cowboyrushforth/graduate/PCB/rx_v2.0/tx.pdf

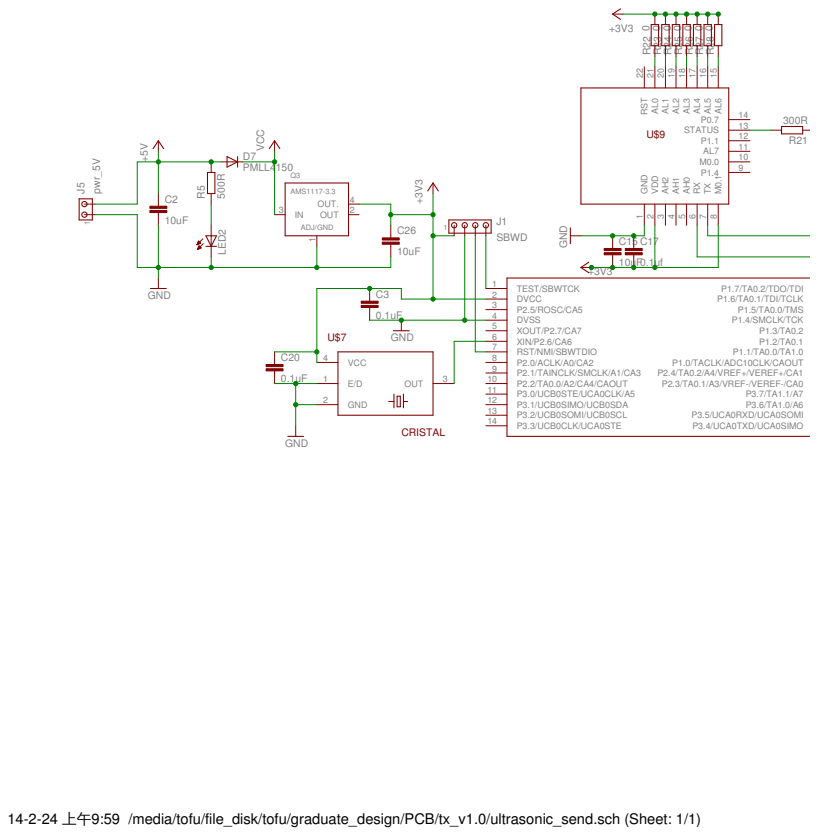
[picture p20: page 1]

P1.7/TA0.2/TDO/TDI P1.6/TA0.1/TDI/TCLK

14-2-24 上午9:59 /media/tofu/file_disk/tofu/graduate_design/PCB/tx_v1.0/ultrasonic_send.sch (Sheet: 1/1)

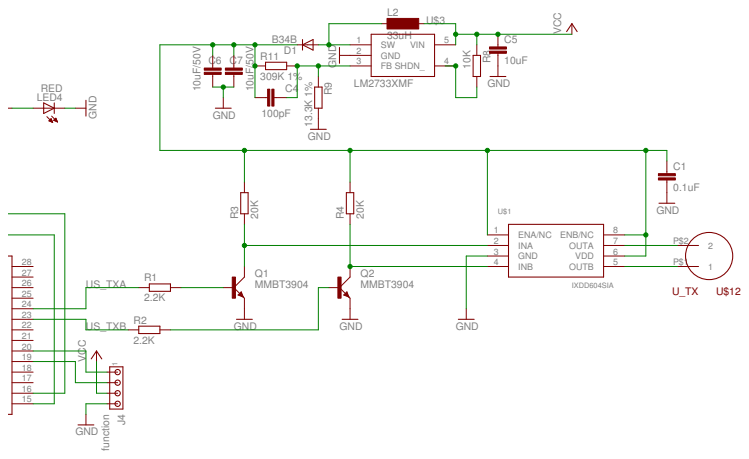
[picture p21: page 2]
