cowboyrushforth/graduate/PCB/rx_v1.0/ultrasonic_send.pdf

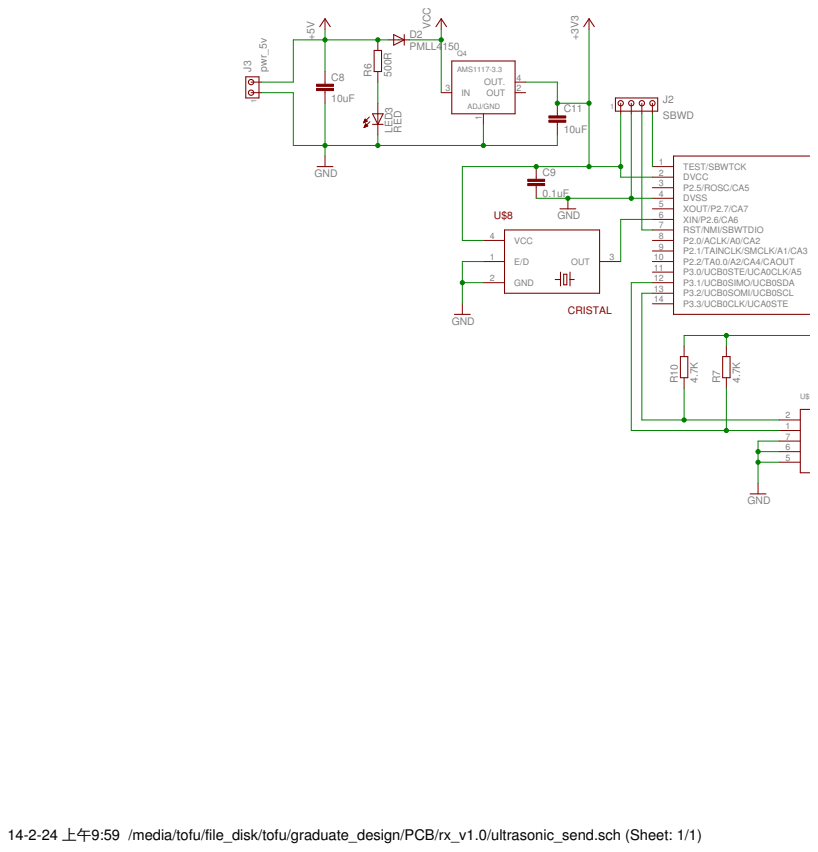
[picture p22: page 1]

14-2-24 上午9:59 /media/tofu/file_disk/tofu/graduate_design/PCB/rx_v1.0/ultrasonic_send.sch (Sheet: 1/1)

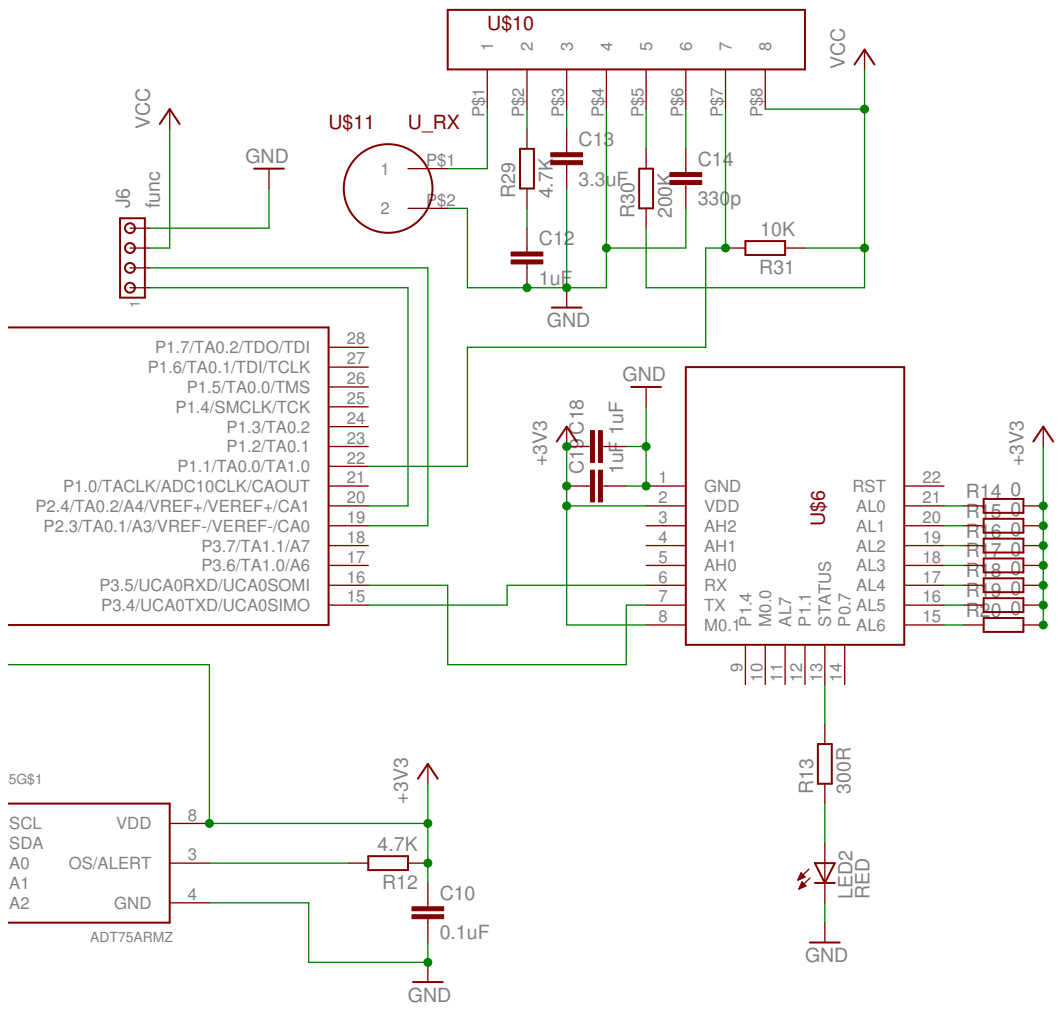
[picture p23: page 2]
