cowboyrushforth/graduate/PCB/tx_v2.0/ultrasonic_send.brd

## EAGLE design PCB/tx_v2.0/ultrasonic_send.brd (2014-04-11)

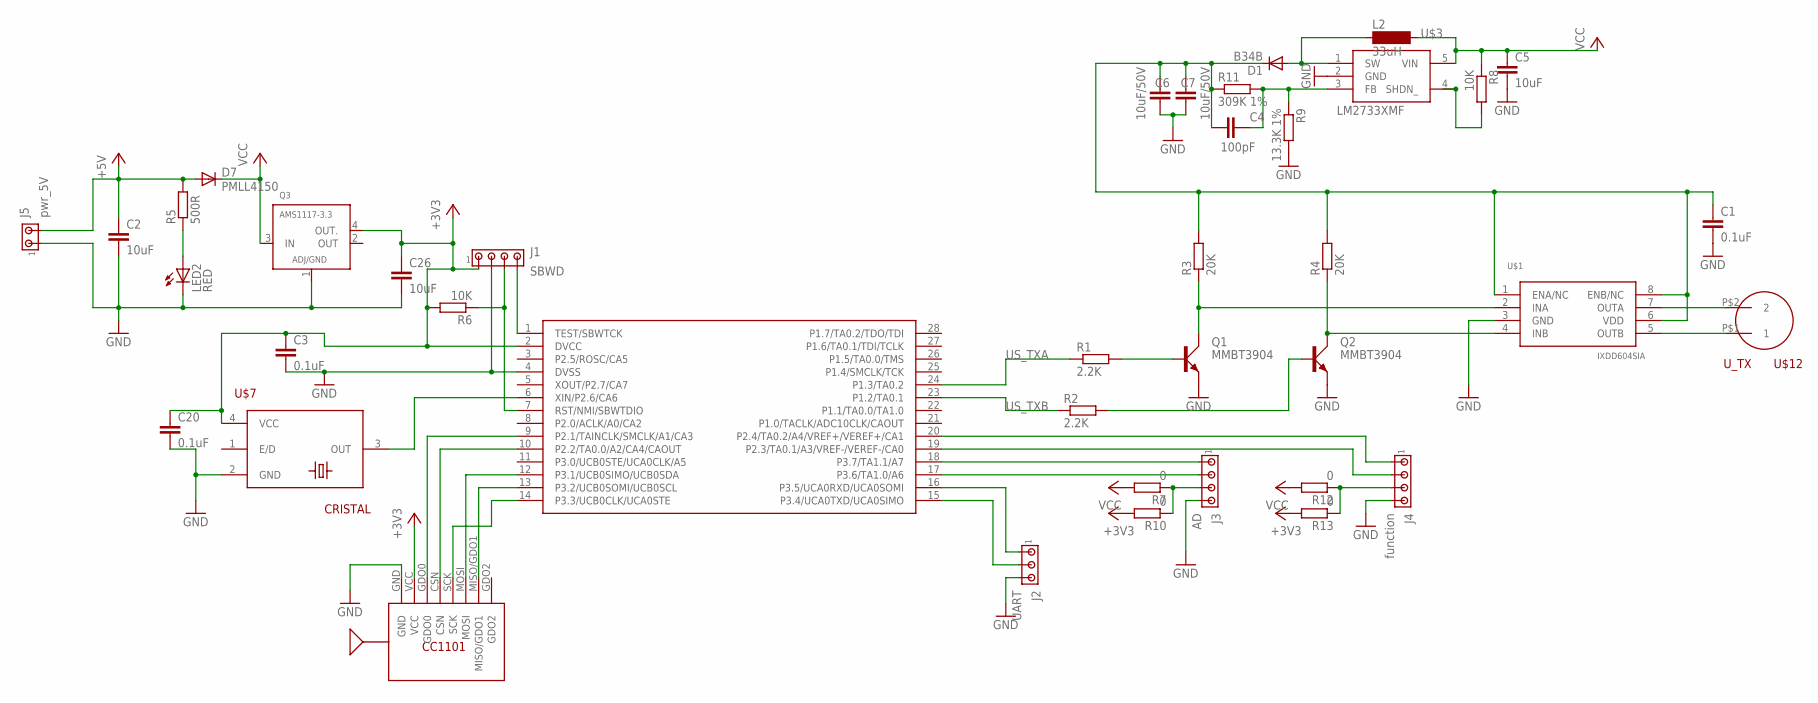
[picture p24: schematic ultrasonic_send.sch]

Parts:
C1, C3, C20: 0.1uF; C0805
C2, C5, C26: 10uF; C0805
C4: 100pF; C0805
C6, C7: 10uF/50V; C1210
D1: B34B; GF1
D7: PMLL4150; SOD80C
J1: SBWD; 10X04MTA
J2: UART; 10X03MTA
J3: AD; 10X04MTA
J4: function; 10X04MTA
J5: pwr_5V; 10X02MTA
L2: 33uH; MS85
LED2: RED; SML0805
Q1, Q2: MMBT3904; SOT23
Q3: AMS1117-3.3; SOT223-4
R1, R2: 2.2K; R0805
R3, R4: 20K; R0603
R5: 500R; R0603
R6, R8: 10K; R0603
R7, R10, R12, R13: 0; R0603
R9: 13.3K 1%; R0603
R11: 309K 1%; R0603
U$1: IXDD604SIA; SO8
U$2: MSP430F2112; PW_R-PDSO-G28
U$3: LM2733XMF; SOT23-DBV
U$4: CC1101
U$7: CRISTAL; CTS406
U$12: U_TX; ULTRASONIC

Connections:
+3V3: C3.1, C20.1, C26.1, J1.1, Q3.4 (OUT.), R6.2, R10.2, R13.2, U$2.2 (DVCC), U$4.VCC, U$7.4 (VCC)
+5V: C2.1, D7.A, J5.2, R5.2
GND: C1.2, C2.2, C3.2, C5.2, C6.2, C7.2, C20.2, C26.2, J1.2, J2.3, J3.4, J4.4, J5.1, LED2.C, Q1.2 (E), Q2.2 (E), Q3.1 (ADJ/GND), R9.2, U$1.3 (GND), U$2.4 (DVSS), U$3.2 (GND), U$4.GND, U$7.2 (GND)
unnamed: Q1.1 (B), R1.2
unnamed: Q2.1 (B), R2.2
unnamed: Q1.3 (C), R3.1, U$1.2 (INA)
unnamed: Q2.3 (C), R4.1, U$1.4 (INB)
unnamed: J1.4, U$2.1 (TEST/SBWTCK)
unnamed: LED2.A, R5.1
unnamed: U$2.6 (XIN/P2.6/CA6), U$7.3 (OUT)
unnamed: C1.1, C4.1, C6.1, C7.1, D1.C, R3.2, R4.2, R11.1, U$1.1 (ENA/NC), U$1.6 (VDD), U$1.8 (ENB/NC)
unnamed: J4.3, R12.1, R13.1
unnamed: J1.3, R6.1, U$2.7 (RST/NMI/SBWTDIO)
unnamed: U$2.9 (P2.1/TAINCLK/SMCLK/A1/CA3), U$4.GDO0
unnamed: U$2.10 (P2.2/TA0.0/A2/CA4/CAOUT), U$4.CSN
unnamed: U$2.12 (P3.1/UCB0SIMO/UCB0SDA), U$4.MOSI
unnamed: U$2.13 (P3.2/UCB0SOMI/UCB0SCL), U$4.MISO/GDO1
unnamed: U$2.14 (P3.3/UCB0CLK/UCA0STE), U$4.SCK
unnamed: J2.1, U$2.16 (P3.5/UCA0RXD/UCA0SOMI)
unnamed: J2.2, U$2.15 (P3.4/UCA0TXD/UCA0SIMO)
unnamed: J3.1, U$2.18 (P3.7/TA1.1/A7)
unnamed: J3.2, U$2.17 (P3.6/TA1.0/A6)
unnamed: J3.3, R7.1, R10.1
unnamed: R8.2, U$3.4 (SHDN_)
unnamed: D1.A, L2.1, U$3.1 (SW)
unnamed: C4.2, R9.1, R11.2, U$3.3 (FB)
unnamed: J4.1, U$2.20 (P2.4/TA0.2/A4/VREF+/VEREF+/CA1)
unnamed: U$1.7 (OUTA), U$12.P$2 (2)
unnamed: U$1.5 (OUTB), U$12.P$1 (1)
unnamed: J4.2, U$2.19 (P2.3/TA0.1/A3/VREF-/VEREF-/CA0)
OUT: Q3.2 (OUT)
US_TXA: R1.1, U$2.24 (P1.3/TA0.2)
US_TXB: R2.1, U$2.23 (P1.2/TA0.1)
VCC: C5.1, D7.C, L2.2, Q3.3 (IN), R7.2, R8.1, R12.2, U$3.5 (VIN)

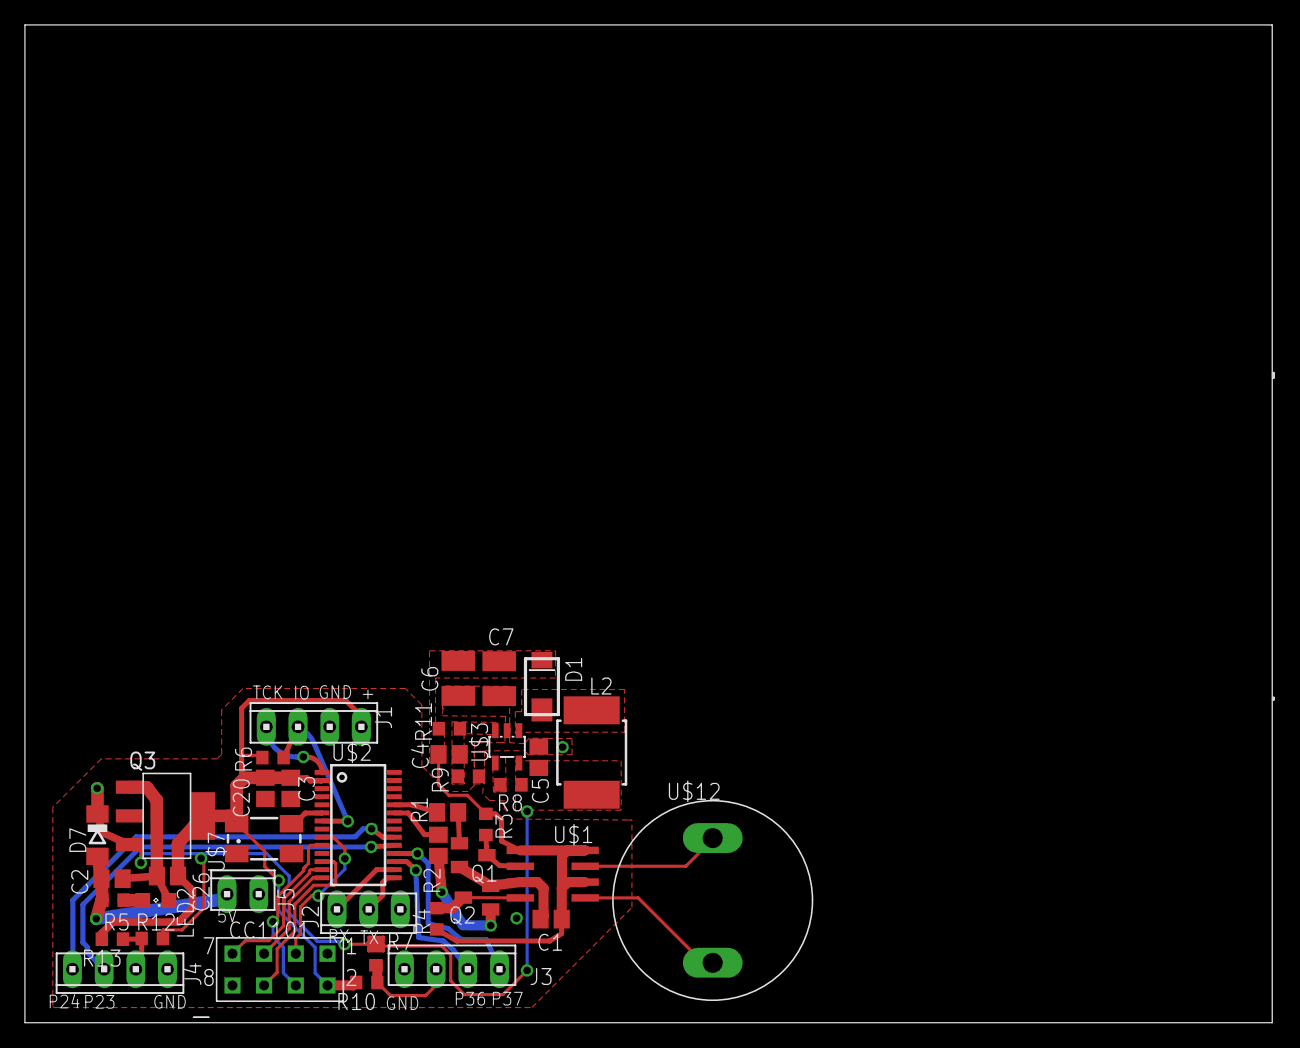
[picture p25: board PCB/tx_v2.0/ultrasonic_send.brd from above]

Board: 2 copper layers, 100.0 x 80.0 mm, 40 parts (0 on the bottom side), 33 nets.
