cowboyrushforth/graduate/PCB/rx_v1.0/ultrasonic_send.brd

## EAGLE design PCB/rx_v1.0/ultrasonic_send.brd (2014-03-02, an earlier design)

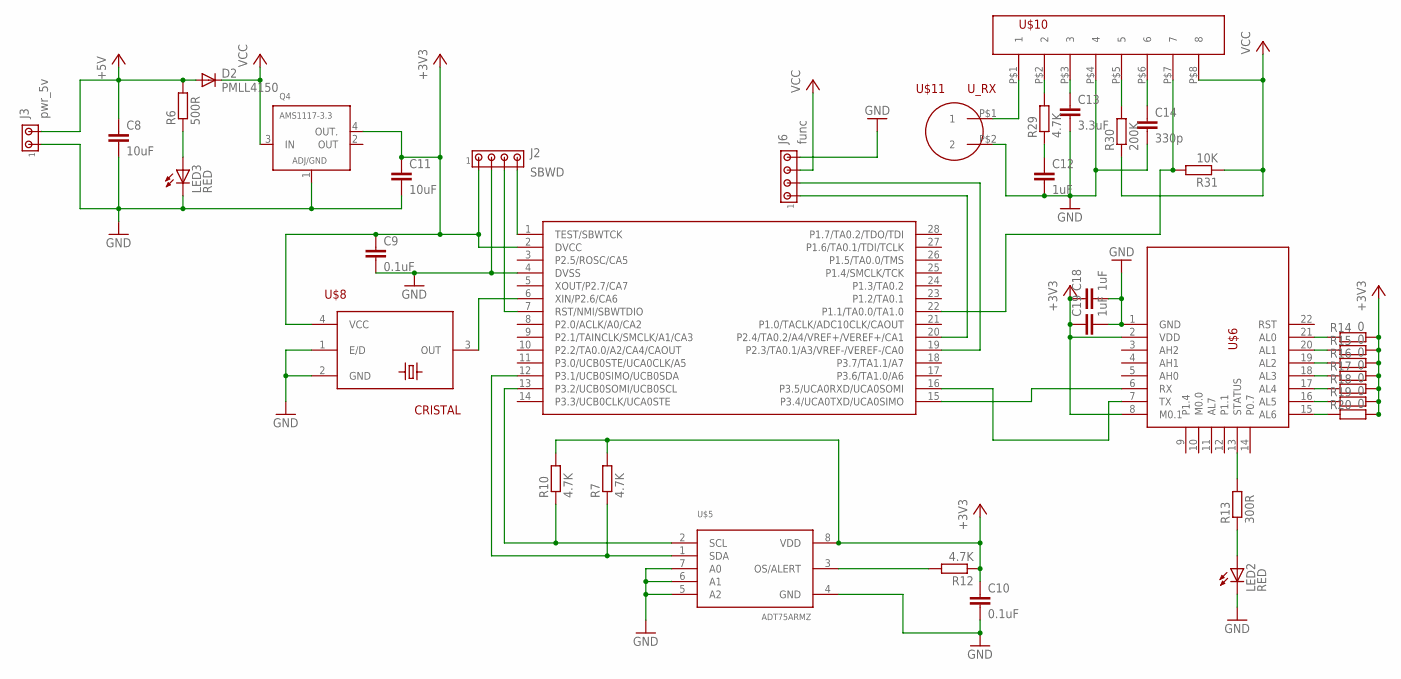
[picture p26: schematic ultrasonic_send.sch]

Parts:
C8, C11: 10uF; C0805
C9, C10: 0.1uF; C0805
C12, C18, C19: 1uF; C0805
C13: 3.3uF; C0805
C14: 330p; C0805
D2: PMLL4150; SOD80C
J2: SBWD; 10X04MTA
J3: pwr_5v; 10X02MTA
J6: func; 10X04MTA
LED2, LED3: RED; CHIP-LED0805
Q4: AMS1117-3.3; SOT223-4
R6: 500R; R0603
R7, R10, R12, R29: 4.7K; R0603
R13: 300R; R0603
R14, R15, R16, R17, R18, R19, R20: 0; R0603
R30: 200K; R0603
R31: 10K; R0603
U$4: MSP430F2112; PW_R-PDSO-G28
U$5: ADT75ARMZ; MSOP08
U$6: ZIGBEE
U$8: CRISTAL; CTS406
U$10: CX20106
U$11: U_RX; ULTRASONIC

Connections:
+3V3: C9.1, C10.1, C11.1, C18.1, C19.1, J2.1, Q4.4 (OUT.), R7.2, R10.2, R12.1, R14.1, R15.1, R16.1, R17.1, R18.1, R19.1, R20.1, U$4.2 (DVCC), U$5.8 (VDD), U$6.2 (VDD), U$6.8 (M0.1), U$8.4 (VCC)
+5V: C8.1, D2.A, J3.2, R6.2
GND: C8.2, C9.2, C10.2, C11.2, C12.2, C13.2, C14.2, C18.2, C19.2, J2.2, J3.1, J6.4, LED2.C, LED3.C, Q4.1 (ADJ/GND), U$4.4 (DVSS), U$5.4 (GND), U$5.5 (A2), U$5.6 (A1), U$5.7 (A0), U$6.1 (GND), U$8.1 (E/D), U$8.2 (GND), U$10.P$4 (4), U$11.P$2 (2)
unnamed: J2.4, U$4.1 (TEST/SBWTCK)
unnamed: J2.3, U$4.7 (RST/NMI/SBWTDIO)
unnamed: LED3.A, R6.1
unnamed: R12.2, U$5.3 (OS/ALERT)
unnamed: R7.1, U$4.12 (P3.1/UCB0SIMO/UCB0SDA), U$5.1 (SDA)
unnamed: R10.1, U$4.13 (P3.2/UCB0SOMI/UCB0SCL), U$5.2 (SCL)
unnamed: U$4.6 (XIN/P2.6/CA6), U$8.3 (OUT)
unnamed: U$4.16 (P3.5/UCA0RXD/UCA0SOMI), U$6.7 (TX)
unnamed: U$4.15 (P3.4/UCA0TXD/UCA0SIMO), U$6.6 (RX)
unnamed: LED2.A, R13.1
unnamed: R13.2, U$6.13 (STATUS)
unnamed: R14.2, U$6.21 (AL0)
unnamed: R15.2, U$6.20 (AL1)
unnamed: R16.2, U$6.19 (AL2)
unnamed: R17.2, U$6.18 (AL3)
unnamed: R18.2, U$6.17 (AL4)
unnamed: R19.2, U$6.16 (AL5)
unnamed: R20.2, U$6.15 (AL6)
unnamed: R29.2, U$10.P$2 (2)
unnamed: C12.1, R29.1
unnamed: U$10.P$1 (1), U$11.P$1 (1)
unnamed: C13.1, U$10.P$3 (3)
unnamed: R31.2, U$4.22 (P1.1/TA0.0/TA1.0), U$10.P$7 (7)
unnamed: R30.2, U$10.P$5 (5)
unnamed: C14.1, U$10.P$6 (6)
unnamed: J6.1, U$4.20 (P2.4/TA0.2/A4/VREF+/VEREF+/CA1)
unnamed: J6.2, U$4.19 (P2.3/TA0.1/A3/VREF-/VEREF-/CA0)
OUT: Q4.2 (OUT)
VCC: D2.C, J6.3, Q4.3 (IN), R30.1, R31.1, U$10.P$8 (8)

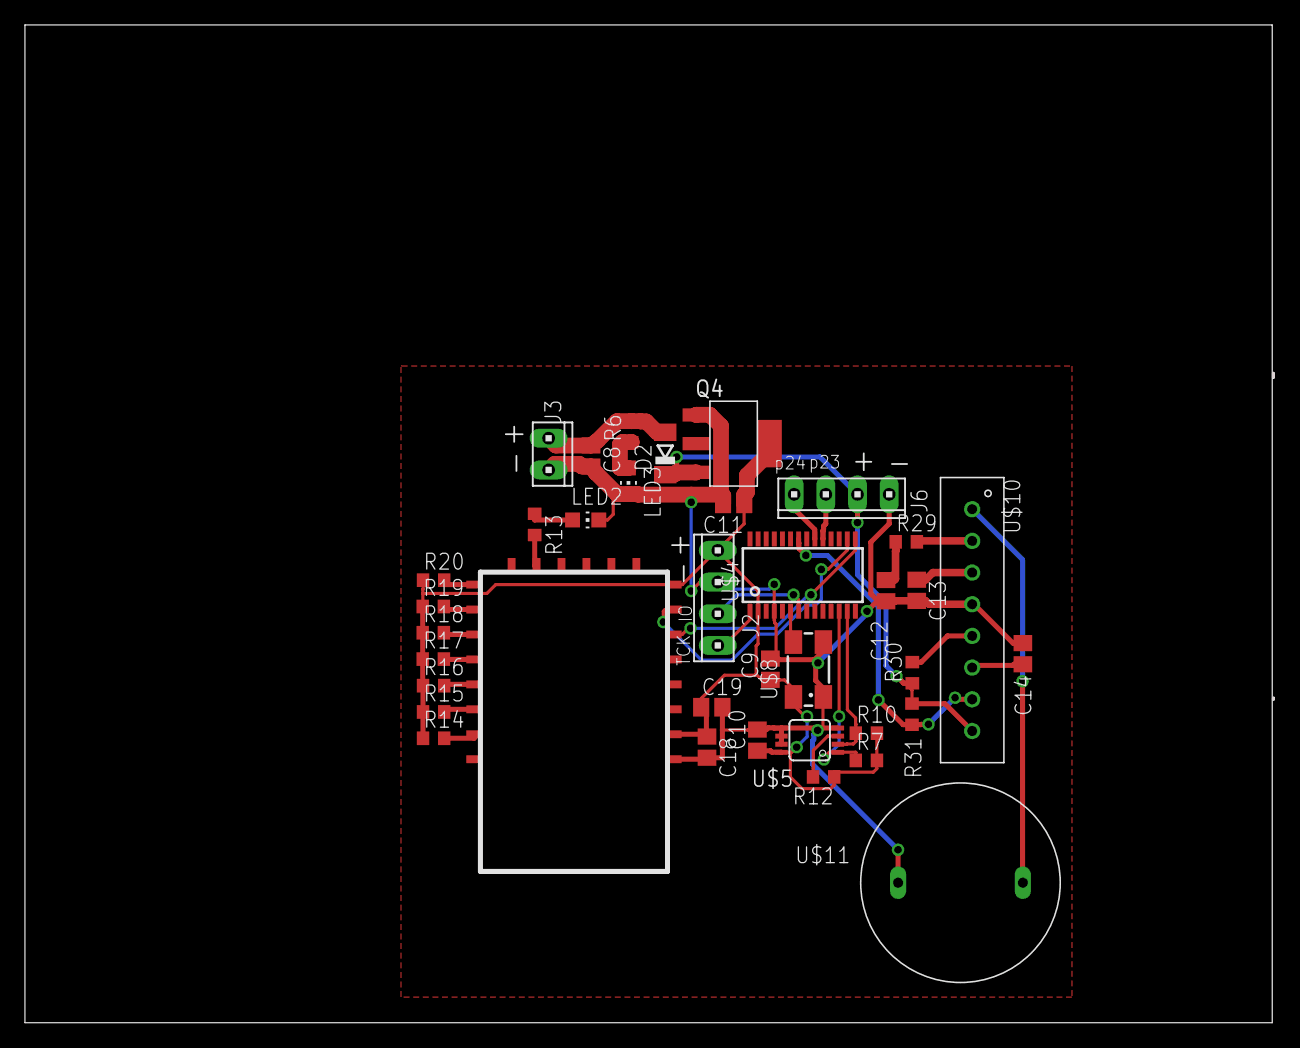
[picture p27: board PCB/rx_v1.0/ultrasonic_send.brd from above]

Board: 2 copper layers, 100.0 x 80.0 mm, 37 parts (0 on the bottom side), 31 nets.
