cowboyrushforth/graduate/PCB/pcb_out/ultrasonic_send.brd

## EAGLE design PCB/pcb_out/ultrasonic_send.brd (2014-04-11)

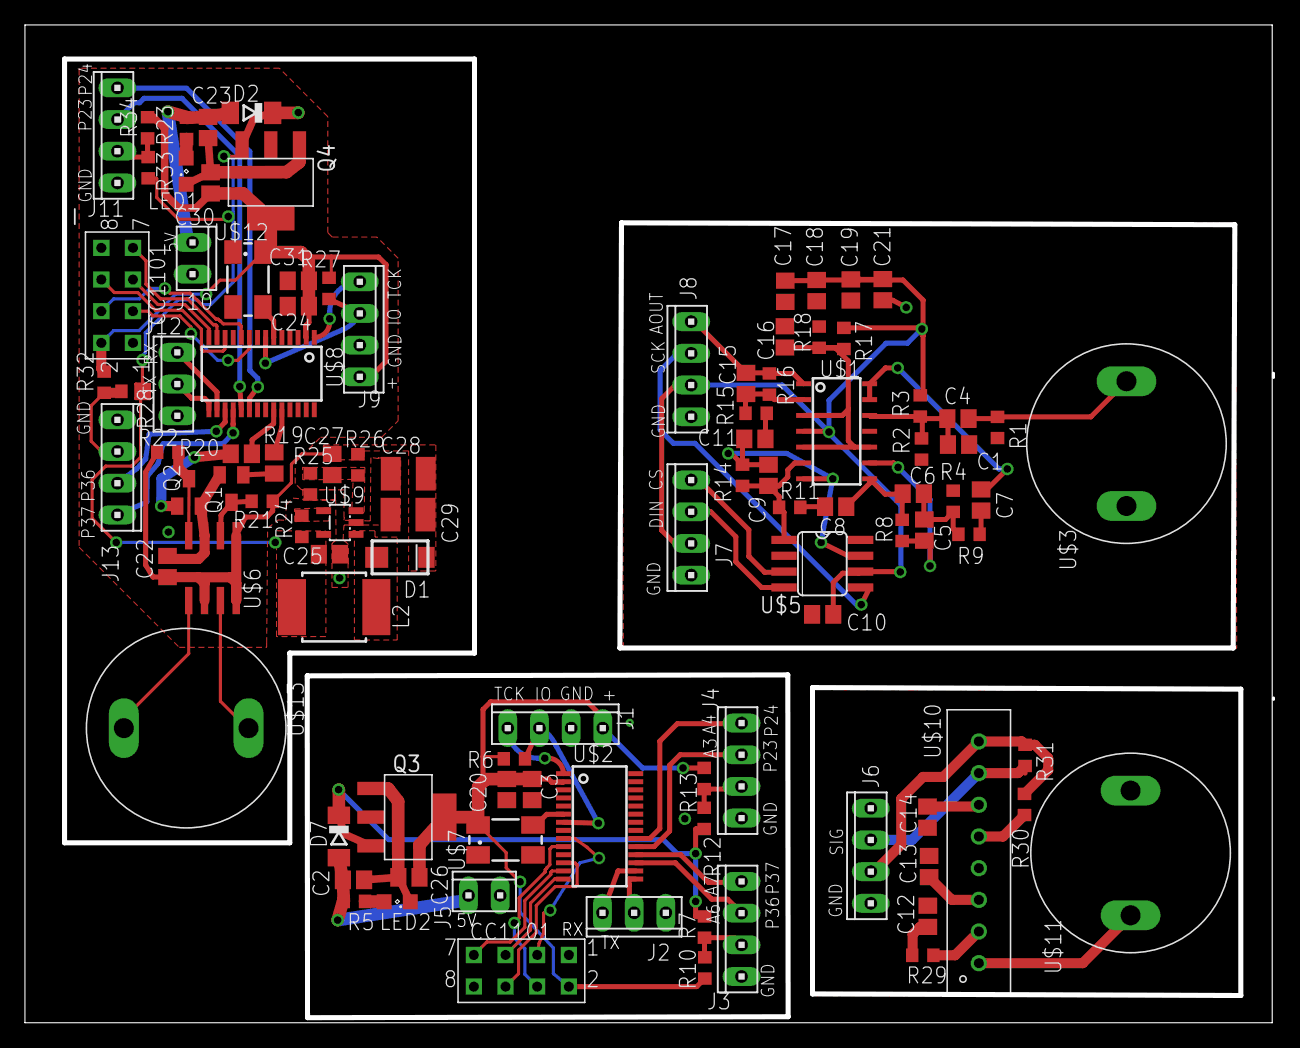
[picture p28: board PCB/pcb_out/ultrasonic_send.brd from above]

Board: 2 copper layers, 100.0 x 80.0 mm, 102 parts (0 on the bottom side), 78 nets.

Parts:
C1, C3, C10, C16, C19, C20, C22, C24, C31: 0.1uF; C0805
C2, C23, C25, C26, C30: 10uF; C0805
C4, C7, C8, C11, C12, C17, C18: 1uF; C0805
C5: 150pF; C0805
C6: 1500pF; C0805
C9, C15, C27: 100pF; C0805
C13: 3.3uF; C0805
C14: 330p; C0805
C21: 1000pF; C0805
C28, C29: 10uF/50V; C1210
D1: B34B; GF1
D2, D7: PMLL4150; SOD80C
J1, J9: SBWD; 10X04MTA
J2, J12: UART; 10X03MTA
J3, J6, J7, J8, J13: AD; 10X04MTA
J4, J11: function; 10X04MTA
J5, J10: pwr_5V; 10X02MTA
L2: 33uH; MS85
LED1, LED2: RED; SML0805
Q1, Q2: MMBT3904; SOT23
Q3, Q4: AMS1117-3.3; SOT223-4
R1, R15: 10K 1%; R0603
R2, R3: 200K 1%; R0603
R4: 8.66K 1%; R0603
R5, R23: 500R; R0603
R6, R24, R27, R31: 10K; R0603
R7, R10, R12, R13, R28, R32, R33, R34: 0; R0603
R8: 82K 1%; R0603
R9: 953R 1%; R0603
R11: 1K 1%; R0603
R14: NC; R0603
R16, R17, R18: 100K 1%; R0603
R19, R20: 2.2K; R0805
R21, R22: 20K; R0603
R25: 13.3K 1%; R0603
R26: 309K 1%; R0603
R29: 4.7K; R0603
R30: 200K; R0603
U$1: OPA1654PW; D_R-PDSO-G14
U$2, U$8: MSP430F2112; PW_R-PDSO-G28
U$3, U$11: U_RX; ULTRASONIC
U$4, U$14: CC1101
U$5: MAX5401EKA-T; SO08
U$6: IXDD604SIA; SO8
U$7, U$12: CRISTAL; CTS406
U$9: LM2733XMF; SOT23-DBV
U$10: CX20106
U$13: U_TX; ULTRASONIC

Connections:
+3V1: C24.1, C30.1, C31.1, J9.1, Q4.4, R27.2, R32.2, R34.2, U$8.2, U$12.4, U$14.VCC
+3V3: C3.1, C20.1, C26.1, J1.1, Q3.4, R6.2, R10.2, R13.2, U$2.2, U$4.VCC, U$7.4
+5V: C2.1, D7.A, J5.2, R5.2
+5V1: C23.1, D2.A, J10.2, R23.2
AMP_OUT: C15.2, J8.1, R16.1, U$1.1
GND: C1.2, C2.2, C3.2, C10.1, C12.2, C13.2, C14.2, C16.1, C17.1, C18.1, C19.1, C20.2, C21.1, C26.2, J1.2, J2.3, J3.4, J4.4, J5.1, J6.4, J7.4, J8.4, LED2.C, Q3.1, R1.1, R2.1, R4.2, R18.2, U$1.11, U$2.4, U$3.P$1, U$4.GND, U$5.2, U$7.2, U$10.P$4, U$11.P$2
GND1: C22.2, C23.2, C24.2, C25.2, C28.2, C29.2, C30.2, C31.2, J9.2, J10.1, J11.4, J12.3, J13.4, LED1.C, Q1.2, Q2.2, Q4.1, R25.2, U$6.3, U$8.4, U$9.2, U$12.2, U$14.GND
unnamed: C4.2, R1.2, U$3.P$2
unnamed: C5.1, R8.1, U$1.9
unnamed: C1.1, C4.1, R2.2, R3.1, U$1.12
unnamed: C6.1, C8.1, R8.2, U$1.8
unnamed: J1.4, U$2.1
unnamed: LED2.A, R5.1
unnamed: U$2.6, U$7.3
unnamed: C5.2, C6.2, R4.1, R9.2
unnamed: J4.3, R12.1, R13.1
unnamed: J1.3, R6.1, U$2.7
unnamed: U$2.9, U$4.GDO0
unnamed: U$2.10, U$4.CSN
unnamed: U$2.12, U$4.MOSI
unnamed: U$2.13, U$4.MISO/GDO1
unnamed: U$2.14, U$4.SCK
unnamed: J2.1, U$2.16
unnamed: J2.2, U$2.15
unnamed: J3.1, U$2.18
unnamed: J3.2, U$2.17
unnamed: J3.3, R7.1, R10.1
unnamed: C7.1, R9.1
unnamed: C7.2, U$1.13, U$1.14
unnamed: C9.1, R11.1, R14.2, U$1.6, U$5.1
unnamed: C9.2, C11.1, R14.1, U$1.7, U$5.7
unnamed: C8.2, R11.2
unnamed: C11.2, R15.2
unnamed: C15.1, R15.1, R16.2, U$1.2
unnamed: Q1.1, R19.2
unnamed: Q2.1, R20.2
unnamed: Q1.3, R21.1, U$6.2
unnamed: Q2.3, R22.1, U$6.4
unnamed: J9.4, U$8.1
unnamed: J9.3, R27.1, U$8.7
unnamed: LED1.A, R23.1
unnamed: J11.3, R33.1, R34.1
unnamed: R24.2, U$9.4
unnamed: U$8.6, U$12.3
unnamed: D1.A, L2.1, U$9.1
unnamed: C27.2, R25.1, R26.2, U$9.3
unnamed: C22.1, C27.1, C28.1, C29.1, D1.C, R21.2, R22.2, R26.1, U$6.1, U$6.6, U$6.8
unnamed: J11.1, U$8.20
unnamed: J4.1, U$2.20
unnamed: J11.2, U$8.19
unnamed: U$8.10, U$14.CSN
unnamed: U$8.12, U$14.MOSI
unnamed: U$8.13, U$14.MISO/GDO1
unnamed: R29.2, U$10.P$2
unnamed: C12.1, R29.1
unnamed: U$10.P$1, U$11.P$1
unnamed: C13.1, U$10.P$3
unnamed: J6.2, R31.2, U$10.P$7
unnamed: R30.2, U$10.P$5
unnamed: C14.1, U$10.P$6
unnamed: U$6.7, U$13.P$2
unnamed: U$6.5, U$13.P$1
unnamed: J4.2, U$2.19
unnamed: J12.1, U$8.16
unnamed: J12.2, U$8.15
unnamed: J13.1, U$8.18
unnamed: J13.2, U$8.17
unnamed: U$8.14, U$14.SCK
unnamed: U$8.9, U$14.GDO0
unnamed: J13.3, R28.1, R32.1
SPI_CS: J7.1, U$5.3
SPI_DATA: J7.2, U$5.4
SPI_SCLK: J8.2, U$5.5
US_TXA: R19.1, U$8.24
US_TXB: R20.1, U$8.23
VCC: C10.2, C17.2, C18.2, C19.2, C21.2, D7.C, J6.3, J7.3, J8.3, Q3.3, R3.2, R7.2, R12.2, R17.1, R30.1, R31.1, U$1.4, U$5.6, U$10.P$8
VCC1: C25.1, D2.C, L2.2, Q4.3, R24.1, R28.2, R33.2, U$9.5
VREF: C16.2, R17.2, R18.1, U$1.3, U$1.5, U$1.10
