cowboyrushforth/graduate/(commit log)

2014-03-02 1.0version tx uart receive finished
    [ultrasonic_send.brd, ultrasonic_send.sch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]
2014-03-12 finish middle term report. add time sync but not work properly
    [main.c, time_delay.py, uart.c, uart.h]
2014-04-08 added CC1101 with lauchboard test.time synchronous precios is under 0.1ms finished new TX PCB with CC1101
    [ultrasonic_send.brd, ultrasonic_send.sch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]
2014-04-11 2.0 PCB finished with CC1101 and reveive modules.
    [ultrasonic_send.brd, ultrasonic_send.sch]
